Gernreich/square-flute/step/square-flute-box-square-3-F4-590.step

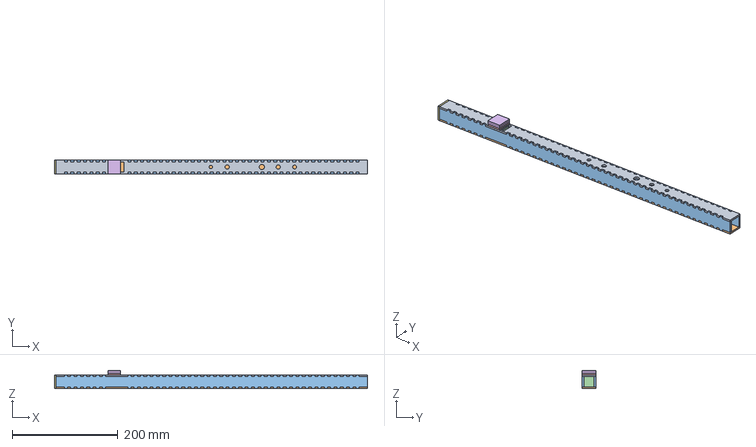
[picture p1: CAD file, 2026-11-09]
step/square-flute-box-square-3-F4-590.step
592.5 x 25.7 x 34.7 mm
