Gernreich/square-flute/step/square-flute-box-square-6.step

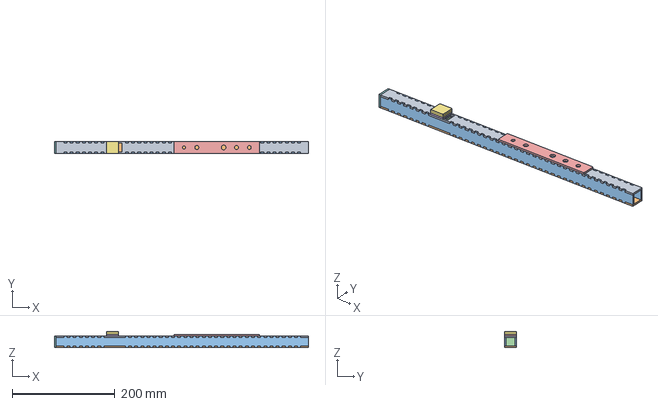
[picture p2: CAD file, 2026-11-08]
step/square-flute-box-square-6.step
495.6 x 22.9 x 31.9 mm
