Gernreich/square-flute/step/square-flute-stack-rect-6.step

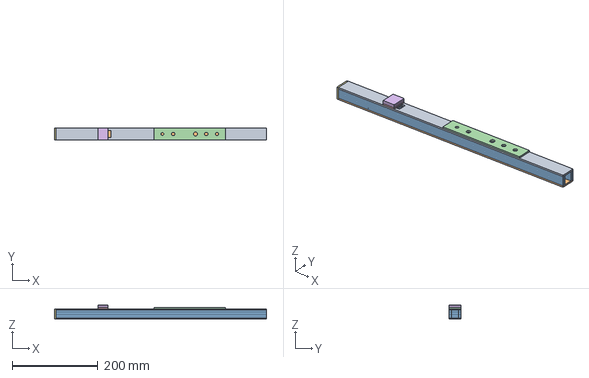
[picture p3: CAD file, 2026-11-08]
step/square-flute-stack-rect-6.step
494.4 x 27.8 x 33.0 mm
