Gernreich/square-flute/step/square-flute-box-square-3-flat.step

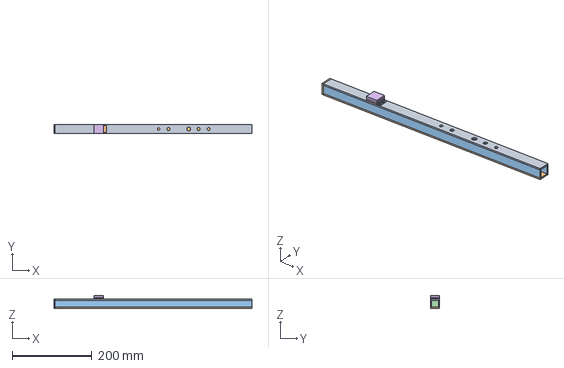
[picture p4: CAD file, 2026-11-08]
step/square-flute-box-square-3-flat.step
497.8 x 22.9 x 31.9 mm
