Gernreich/square-flute/step/square-flute-stack-rect-3.step

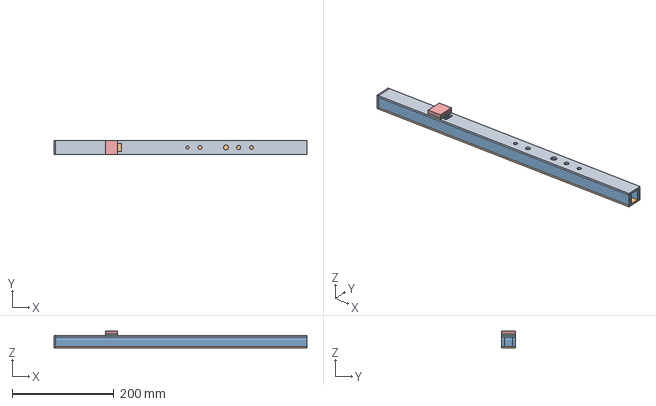
[picture p5: CAD file, 2026-11-08]
step/square-flute-stack-rect-3.step
496.6 x 27.8 x 33.0 mm
