Gernreich/square-flute/step/square-flute-box-square-3.step

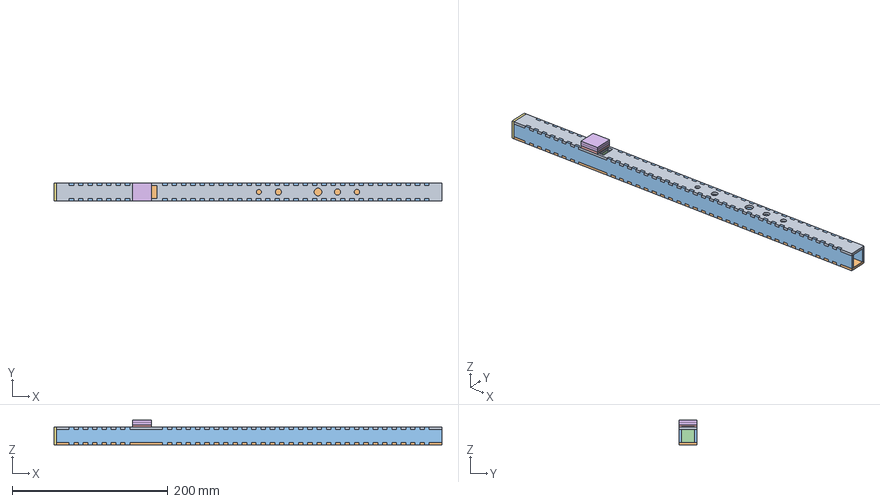
[picture p6: CAD file, 2026-11-08]
step/square-flute-box-square-3.step
497.8 x 22.9 x 31.9 mm
