Gernreich/square-flute/(list of files, cad)

Other CAD files:
step/square-flute-box-square-3-E4-590.step
step/square-flute-box-square-6-flat.step
