Gernreich/square-flute/(commit log)

2026-10-13 Square-bore flute in A4: model, generator, six variants
    A five-hole minor-pentatonic flute in the Native American style, at the bore
    area of a 7/8in round-bore flute. naf_model.py is a transmission-matrix model;
    square_flute.py builds three bores (box square, box rectangular, laminated
    stack) each with the holes in 3mm or 6mm of wall; compare_page.py shows all
    six in 3D. .repro claims all 18 shipped files.
2026-10-13 Add the author's 2017 flute: the originals, and redrawn
    yours/original/ holds the 2017 files unchanged. your_flute.py measures them,
    predicts what the model hears (a minor pentatonic to within 40 cents, near
    B-flat 4), and redraws the flute flat-jointed and box-jointed: millimetre-true,
    kerf-compensated, house colours, a 12mm plug of four discs, the original's
    engraved bevel ramp and hole depressions kept. The six variants are untouched.
2026-10-13 Your flute: the engraved bevel did not work; file the edge, split the top
    The author reports the 2017 greyscale ramp did not cut a usable splitting
    edge. The redraw drops it, files the edge by hand, and cuts the top as a head
    plate and a body plate 20mm past the window, as the six variants do. The
    README and the page no longer call the ramp an improvement. The original
    files are unchanged.
2026-10-13 Six -plus variants: the six again with the 2017 flute's ideas
    plus_flute.py folds five ideas from the author's flute into each variant:
    a full-width window and exit hole, the flue engraved in the nest, the stepped
    block, a mouthpiece cap and an engraved depression round every hole. The model
    is rerun at the wider window, which moves the foot about 18mm down. Box tabs
    stay clear of the full-width openings. square_flute.py and its six are
    untouched; .repro now claims 40 files.
2026-10-13 Viewer note names where each flue is; drop the ramp's dead code
    The 3D note said the bird carries the flue, true only of the first six.
    your_flute.py lost its image rotation, unused since the ramp went. The README
    and page record that the 2017 flutes were given away, so the first new build
    calibrates the window, and that the depressions worked on a Glowforge with the
    xTool untested. No cut file changes.
2026-10-13 Lens review: the window term moves the holes too; flue and glue scoped
    The README and the model said each 1mm of window correction moves the foot
    5.5mm and the holes far less. Run through the model: 4.5mm (2.6 at a full-width
    window), and the holes 2.3-3.0mm against the foot's 3.5, so trimming the foot
    does not tune them. The flue paragraph described only the six; the glue list
    missed the -plus cap; the -plus shift is 16.5-18mm, not 18; Regenerating lacked
    two generators; the depressions now name XCS Grayscale mode, per the author.
2026-10-13 Mouthpiece cap: a notch in the bottom edge, not a centred hole
    The original's 9.59mm circle is centred 0.33mm inside the cap's edge, so
    cutting both leaves a half-round notch; the author confirms it goes to the
    bottom, away from the finger holes, opening through the bottom wall into the
    bore. All eight caps are redrawn with the notch in the black outline, which
    also keeps the circle from cutting the next part on the sheet. A new check
    in both generators confirms the notch reaches the air.
2026-10-13 The author's mouthpiece cap on every variant, the six included
    At the author's asking, the 2017 cap with its bottom-edge notch now goes on
    the six as well as the -plus variants and the redraws. cap_part and cap_path
    move into square_flute.py, which all three generators share; the cap is the
    last part of each of the six, so their other part numbers do not move. No
    hole or foot moves: the cap is upstream of the plug. A check confirms the
    notch reaches the air on every variant.
2026-10-13 True finger joints, the trumpet bores' own, on every box
    The box variants were tabs in mortices with 2mm of plate outboard of each:
    faux finger joints, the author says, with a sliver showing. Every box, -plus
    box and the 2017 flute's fingers build now uses Boxes.py's FingerJointSettings
    as the trumpet bores do -- 6mm fingers and spaces, no play, the fit from the
    kerf -- with the fingers running flush to the outside faces. Each box is 4mm
    narrower. New checks: fingers flush, no notch beside a full-width opening,
    depressions clear of the notches. Stacks are unchanged.
2026-10-13 Lens review: --mouth=0.8 runs, the hero fits a phone
    Lens 2: the README's recalibration example, naf_model.py --mouth=0.8, crashed:
    a hole was fenced by the one above it, which still stood at the old guess.
    The fence now moves back when a hole cannot reach its note, and the equal-holes
    comparison prints 'no layout' where none exists. At the default window nothing
    moves; all 40 files reproduce. Lens 8: the hero image was 720px fixed and
    pushed a 400px page sideways; it is fluid now. Lens 4/10: the notch is 0.33mm
    inside the edge, not on it, and 'sound well together' became what it means.
    plus_flute's finger list is called fingers, not tabs.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
2026-10-13 The 2017 flute at A4, in place of the builds at its original size
    your_flute.py scales every pitch-setting dimension by 1.0705, solved so the
    model gives 440Hz: bore 20.74 x 24.02mm, window, holes, sound chamber 335.3mm.
    Ply-fixed parts do not scale, so the intervals widen 4-12 cents; the README
    says so and gives the notes. The two builds at the original size are removed
    at the author's asking; yours/original/ keeps the 2017 files.
2026-10-13 The 2017 flute at A4: hole sizes re-solved for equal temperament
    Plain scaling left the notes 4-47 cents sharp, the 3mm wall not scaling with
    the holes. Each hole keeps its scaled position and its diameter is bisected,
    foot-most first, until its note lands on equal temperament against A4=440:
    8.10, 7.35, 7.26, 7.76, 6.35mm. Holes 2 and 3 depart most, about 1mm (13%)
    smaller than scaling. Every note within 0.01 cents; the fundamental 0.8 cents
    high, inside the 1-cent check, so the 1.0705 scale stands. The tape caveat is
    gone from the README.
2026-10-13 Lens review: the A4 change left four stale claims
    The rings were 'embedded at the original size' and now follow the re-solved
    holes; the generator said 'nothing acoustic is tweaked' over a flute now
    scaled and re-holed; the B-flat 4 reading did not say it was of the original
    size, and is now headed so; the page and the regenerate comment said
    'redrawn' without 'at A4'.
2026-10-13 One-piece top on every build; the page links back to the README
    The top was a head plate and a body plate, so a hand-filed edge that went
    wrong would cost only the short one. The author saw no point in it: it saved
    one strip of ply, and cost a seam 20mm past the window and a gap in the
    finger joints where the bird is tied. Every build now has one top plate, the
    fingers run unbroken, and the edge is filed before assembly. Each build has
    one part fewer; nothing acoustic moves.
    The published page is built from this README, so its 'Read the writeup' link
    pointed at itself. Marked readme-only, with a page-only 'Read the README', as
    living-hinge does.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
2026-10-13 Plan drawings: draw the flue, and the plug inside the bore
    The light brown band was the plug, drawn across the flute's whole outside
    width, and the flue was not drawn at all. The flue is now its own band from
    the exit hole to the window, exactly as wide as the two openings it joins --
    10mm in the six, the bore's width in the -plus variants -- and the plug a
    dashed outline inside the walls. The key names both.
2026-10-13 Every build: full-width window and exit hole, and the hole depressions
    At the author's asking, the six take the 2017 flute's full-width window and
    exit hole, with the flue across the bore's width, and its depression round
    every finger hole. The model is run at the full-width window for every box
    and stack build (naf_model.window; the round reference keeps its 10mm), so
    the six move to the -plus layouts: sound chambers 343.7-346.9mm. A variant
    and its -plus version now differ only in where the flue is engraved, the
    bird or the nest. README and page numbers re-derived: shape within 1.5mm
    (the window, not the bore), the wall 11-17mm, equal holes 28/31/47/15mm.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
2026-10-13 Woodland and plains: name the pair, and where each sends the air
    The six carve the flue in the bird, the woodland style; the -plus six and the
    2017 flute carve it in the nest, the plains style. Kept as a pair, at the
    author's asking. The README now says so, with Flutopedia's anatomy and
    glossary, and notes the consequence: a bird flue leaves the air just above
    the top plate, a nest flue just below, about one flue depth apart at the
    splitting edge. A spacer plate, the third traditional way, sends the air
    where a bird flue does; it differs only in the making.
2026-10-14 One document: the variants page folded into the writeup
    At the author's asking, variants.html is gone and README.md -> index.html is
    the one page. It gains 'Turn it in 3D' (viewer.js, loaded through a page-only
    line, so GitHub shows a link to the page instead), the two hole layouts as
    plain SVG plans that read on GitHub too, and 'Every cut sheet' with every
    build's previews. page_assets.py replaces compare_page.py, builds viewer.js
    and the plans, and folds the page into one file for the claude.ai artifact.
    .repro claims viewer.js and the plans: 42 reproduce.
    The viewer now draws each flue on the face it is engraved into. Every flue
    was drawn on its part's underside, which hid a -plus nest f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
2026-10-14 The author's flute at box-square-3's bore; a flue toggle in 3D
    - your_flute.py: the two A4 builds now have the same bore area (387.1mm^2,
    the original's proportion, 18.28 x 21.18mm) and the same length end to
    end as box-square-3 (346.9mm sound chamber, 487.4mm overall, 15mm foot
    spare), the holes kept as fractions of the chamber; window (7.31mm) and
    hole diameters solved for A4 in equal temperament. Replaces the 1.0705
    scaling.
    - 3D viewer: one button per build plus a bird/nest flue toggle; the bird's
    flue layer turns over as it explodes so its flue shows; the plug discs
    explode in order instead of passing through each other.
    - README: builds table down to four rows; box-rect's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
2026-10-14 The bore at 3/4in, as Flutopedia gives for A4
    - naf_model.py: REF_BORE 19.05mm (was 22.2), area 285.0mm^2. The stack
    goes to 18mm deep, six bore layers, 15.83 x 18; the box is 16.88 square.
    Every hole, length and figure re-solved: builds 491-495mm long.
    - The hole solver restarts its guess at the chamber's real length after
    the first pass. Left at 330mm, the 3/4in bore's 357mm chamber boxed
    hole 2 in, and no layout came out for 3mm of wall.
    - The stack builds now fit one sheet each: the sheet-2 files go.
    - The author's flute follows box-square-3: 15.69 x 18.17mm, 494.8mm,
    window 7.01mm, holes 4.6-5.2mm.
    - README, docstrings and the round reference's label updated to match.
    Co-Auth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
2026-10-14 Flat or finger-jointed boxes, a joints toggle; the 2017 redraws go
    - square_flute.py, plus_flute.py: a 'flat' box kind -- plain plates, the
    sides glued between the top and the bottom, as the 2017 flute was built.
    Four new builds, box-square-{3,6}-{bird,nest}-flue-flat.
    - 3D viewer: four build buttons, a flue toggle and a joints toggle
    (disabled for the stacks).
    - yours-flat-A4 and yours-fingers-A4 removed at the author's asking: at
    the 3/4in bore each was a box-square-3 nest-flue build in all but its
    holes and block. your_flute.py keeps the measurement, the model's reading
    of the original, the leather tie and the sheet writer plus_flute.py uses.
    - .repro claims 30.
    Co-Authored-B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
2026-10-14 A half-round notch in the bottom plate's mouth end; a hole-wall toggle
    - Every bottom plate (and the stack's bottom layer) has the cap's 9.59mm
    circle cut half-round into its mouth end, midway across: at right angles
    to the cap's notch, the two meet at the bottom corner as one opening.
    Drawn into the kerf-grown outline as an arc, into the 3D outline as
    points; checked to open inside the bore.
    - 3D viewer: two construction buttons and three toggles -- hole wall 3/6mm,
    flue bird/nest, joints fingers/flat.
    - The 7/8in starting point is no longer mentioned.
2026-10-14 A savanna flue, half in the bird and half in the nest; red part numbers
    - plus_flute.py: six -savanna-flue builds, the flue fill-engraved about
    0.5mm in the nest and 0.5mm in the bird's underside, checked to line up
    over the plug. The author's "where the woodlands meet the prairie".
    - 3D viewer: the flue toggle gains "both (savanna)".
    - Part numbers move to red #ff0000 in every cut file, so they can be scored
    light on their own layer while the flue engraves deep in blue.
    - .repro claims 42.
2026-10-14 No part numbers; the flue buttons name their styles
    - The cut files carry no part numbers (the author: the 3D view shows where
    each part goes), so the red ink goes too. Only the flue and the hole
    depressions are engraved.
    - 3D viewer: bird (woodland), nest (plains), both (savanna).
2026-10-14 Writeup review: stale docstrings, a contradiction, a misleading row order
    - square_flute.py: its own --only= example named a build that no longer
    exists; "four builds", "tabbed" sides and the 0.1mm shape claim brought
    up to date (six builds, true finger joints, 1.2mm at each bore's window).
    - README: the builds table said the bird is glued, Tuning says it is tied;
    it is the bird's layers that are glued. "1 user unit = 1 mm" now quotes
    the files' own "1mm". The files table and gallery put nest-flat after
    savanna under "the same, butt-jointed", so they now run nest, nest-flat,
    savanna, savanna-flat. "The two traditional places" and "all three"
    written for three flues; .repro clai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
2026-10-14 README: an Assembly section, box, flat box and stack
2026-10-14 README: the Assembly section taken out again, at the author's asking
    This reverts commit b89aa4c.
2026-10-14 turn.html: the 3D view on a page of its own, so the hub can frame it
2026-10-14 Cut sheets and previews regenerated: they embed ring.png, now without its metadata; pixels unchanged
2026-10-18 --kerf= on every generator; the foot cut 15mm longer, the bird's tie
    set_kerf() sets the one KERF the sheet writers read, so a loose or tight
    press-fit is a recut, not an edit. README: the sound chamber is cut 15mm
    longer than the model's, not 15mm long; tuning names the leather tie.
2026-10-18 Six builds, each with a savanna flue in two inks
    Every build carries both halves of the flue: red in the bird's underside,
    magenta in the nest over the plug. The laser runs either for a woodland
    or plains flue, or both for a savanna one, so the bird-, nest- and
    savanna-flue builds (18 cut files) become six. plus_flute.py goes;
    square_flute.py draws them all and checks the halves line up. The 3D
    view loses its flue toggle and draws each half in its ink.
2026-10-18 Builds in binary order: box/stack, 3/6, fingers/flat, 000 to 110
2026-10-19 A 10% window error moves the holes 2.0-2.4mm, over all six builds both ways
2026-10-19 Bed is 600 x 305mm, cut-tested
    The largest rectangle the xTool P2S cut, tested 2026-10-19, is 600 x 305mm,
    not the 600 x 308 assumed here until now. Every shipped sheet still fits and reproduces;
    the ocarinas and the octagonal flute import this BED.
2026-10-22 Link back to all projects at the top of the README and the page
    The rest of the build files now points at lasermademusic.html, where the
    instruments moved when the root page became a directory.
2026-11-07 Call lasermade-tools' Rust programs, not its Python scripts
    The tools became Rust on 2026-11-07: target/release/<name> in lasermade-tools
    (cargo build --release there) replaces python3 <name>.py, in commands,
    manifests and prose. Pages rebuilt; no generated file changes otherwise.
2026-11-07 square_flute.rs: the part, kerf, finger joint and packing in Rust, for the Rust generators that borrow them
2026-11-08 The generators are Rust: square_flute, naf_model (with --bores for bore-tmm), page_assets, your_flute; every cut file, plan and page byte for byte the same
2026-11-08 Cargo.lock: bore-tmm now depends on lasermade-tools and roxmltree
2026-11-08 STEP files of the 3D view, for a CAD program
    One file per design in step/, one solid body per part, written from the
    3D page by lasermade-tools step-export and checked by .repro. Every file
    opens in SolidCraft with every body closed and no warnings.
    [square-flute-box-square-3-flat.step, square-flute-box-square-3.step, square-flute-box-square-6-flat.step, square-flute-box-square-6.step, square-flute-stack-rect-3.step, square-flute-stack-rect-6.step]
2026-11-08 Every build as a parametric SolidCraft design; the STEP files built by SolidCraft
    solidcraft.rs writes solidcraft/*.solidcraft.json (square_flute --solidcraft=DIR):
    ply, bore, head, plug, doubler, bird, cap and notches as expressions, the box's
    fingers re-counted as fingers_x counts them, the flue drawn as a savanna flue.
    The tuning stays the solver's, as parameters. Matches the old STEPs to 0.012 mm
    part by part but for the flue.
    [square-flute-box-square-3-flat.step, square-flute-box-square-3.step, square-flute-box-square-6-flat.step, square-flute-box-square-6.step, square-flute-stack-rect-3.step, square-flute-stack-rect-6.step]
2026-11-09 Two long builds: box-square-3 at 589.5 mm in F4 and E4
    The box flute as long as the bed allows, in whatever key that length sounds.
    naf_model gains design_held(): the chamber held, the closed note found, the
    holes laid out for the minor pentatonic on it. A 19.70 mm square bore keeps
    the biggest hole's ply beside the finger notches, the hands are 31 mm apart
    for large fingers. E4 takes 30 mm from the slow air chamber for the sound
    chamber. build() and the SolidCraft writer take the slow air chamber, bore
    and key per build; the six A4 builds are byte-identical. Cut sheets checked
    against the designs' solids with sc-flatten and sc-compare (0.03 mm).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
    [square-flute-box-square-3-E4-590.step, square-flute-box-square-3-F4-590.step]
2026-11-09 naf_model --bores: the two long builds, with their own notes
    bore-tmm reads every cut sheet against these; the A4 builds' entries are
    unchanged.
